Pendatkill/myradarhr05/README.md

<p align="center">
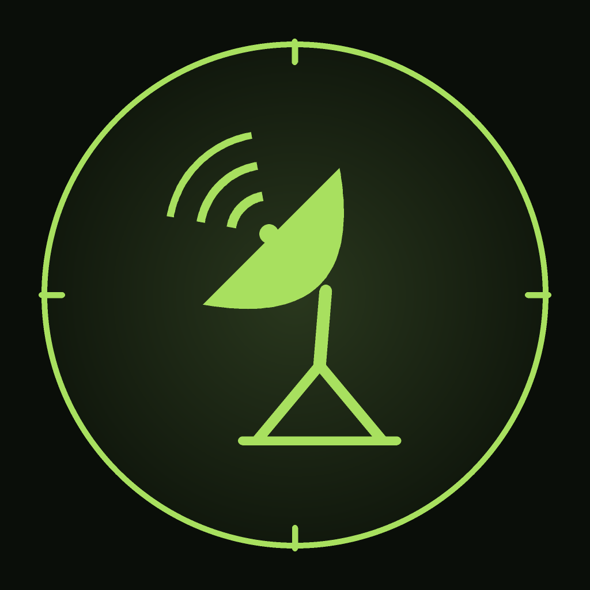
[picture p1: docs/icono_app.png]
Icono de My Radar: antena parabólica
  
</p>

<h1 align="center">My Radar</h1>
<p align="center">Radar ultrasónico con ESP32, visor web, visor de escritorio y app Android<br>by <b>pendatkill_dev</b></p>

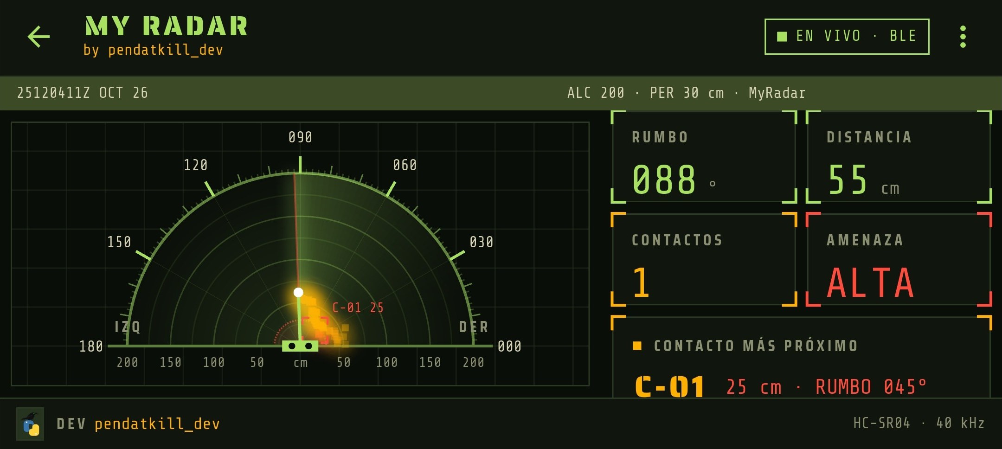
[picture p2: docs/app_radar.jpg]
App My Radar en un móvil Android, conectada por Bluetooth LE: radar semicircular con un contacto C-01 a 25 cm, rumbo 088°, distancia 55 cm y nivel de amenaza ALTA


Un sensor HC-SR04 montado sobre un servo SG90 barre 176° y mide la distancia a lo que tiene delante. El ESP32 envía cada medida por **USB**, **WiFi** y **Bluetooth LE**, y tres clientes la dibujan como una pantalla de radar:

| Cliente | Conexión | Carpeta |
|---|---|---|
| App Android **My Radar** (Flutter, estilo consola táctica) | WiFi o Bluetooth LE | [`my_radar_app/`](my_radar_app/) |
| Visor web (Chrome o Edge, sin instalar nada) | USB con Web Serial | [`visor_web/`](visor_web/) |
| Visor de escritorio (Python + pygame) | USB | [`visor_pc/`](visor_pc/) |

## El montaje

<p align="center">
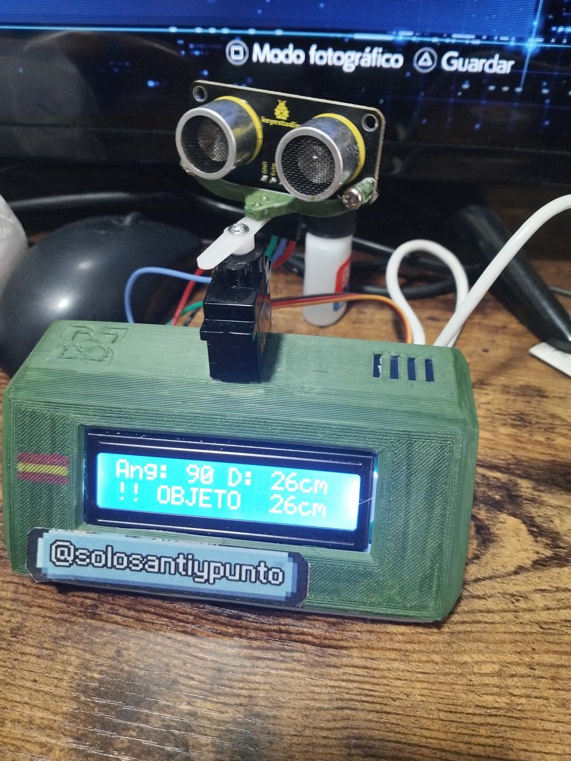
[picture p3: docs/montaje.jpg]
Radar montado: caja verde impresa en 3D con la pantalla LCD mostrando «Ang: 90 D: 26cm» y «!! OBJETO 26cm», el servo encima y el sensor ultrasónico sobre su brazo
  
</p>

Caja impresa en 3D con la pantalla LCD en el frente. El servo asoma por arriba y lleva el sensor en un soporte atornillado a su brazo. En la foto, la LCD avisa de un objeto a 26 cm, dentro del perímetro de alerta de 30 cm.

## Lista de materiales

| Cant. | Componente | Notas |
|---|---|---|
| 1 | Placa de desarrollo ESP32 (ESP32-WROOM-32) con USB-serie CH340 o CP2102 | Hace falta WiFi y Bluetooth LE |
| 1 | Sensor ultrasónico HC-SR04 | El firmware usa de 2 a 200 cm |
| 1 | Microservo SG90 | Con su brazo de plástico |
| 1 | Pantalla LCD 1602 con adaptador I2C (PCF8574) | Dirección 0x27; algunas usan 0x3F |
| 1 | Resistencia de 1 kΩ | Divisor de tensión del ECHO |
| 1 | Resistencia de 2 kΩ | Divisor de tensión del ECHO |
| 1 | Condensador electrolítico de 470–1000 µF, 10 V o más | En la alimentación del servo |
| 1 | Fuente de 5 V y 1 A | Recomendada para el servo |
| ~10 | Cables dupont | Según tu montaje, macho-hembra o hembra-hembra |
| 1 | Cable USB de datos | Uno solo de carga no sirve para programar |
| 1 | Caja y soporte del sensor impresos en 3D | PLA. Ver [Piezas impresas en 3D](#piezas-impresas-en-3d) |
| — | Tornillería pequeña | Para fijar el soporte al brazo del servo |

## Piezas impresas en 3D

Hay muchos diseños libres para este montaje. Busca uno que encaje con tus componentes:

| Pieza | Yeggi | Cults3D |
|---|---|---|
| Radar completo (sensor + servo) | [Buscar](https://www.yeggi.com/q/ultrasonic+radar+servo/) | [Buscar](https://cults3d.com/en/search?q=ultrasonic+radar) |
| Soporte del HC-SR04 para el brazo del SG90 | [Buscar](https://www.yeggi.com/q/hc-sr04+sg90+mount/) | [Buscar](https://cults3d.com/en/search?q=hc-sr04+servo+mount) |
| Caja para LCD 1602 | [Buscar](https://www.yeggi.com/q/lcd+1602+case/) | [Buscar](https://cults3d.com/en/search?q=lcd+1602+case) |
| Caja para ESP32 | [Buscar](https://www.yeggi.com/q/esp32+case/) | [Buscar](https://cults3d.com/en/search?q=esp32+case) |

Antes de imprimir, comprueba las medidas de tu placa ESP32 y de tu LCD: varían entre fabricantes.

## Conexiones

| Componente | Pin del ESP32 |
|---|---|
| Servo SG90 (señal) | GPIO 18 |
| HC-SR04 TRIG | GPIO 19 |
| HC-SR04 ECHO | GPIO 23, **a través de un divisor de tensión** |
| LCD 1602 I2C | SDA GPIO 21 · SCL GPIO 22 |

> **ECHO a 5 V.** El HC-SR04 devuelve 5 V y los GPIO del ESP32 solo admiten 3,3 V. Pon un divisor `ECHO — 1 kΩ — GPIO23 — 2 kΩ — GND` o usa un HC-SR04P alimentado a 3,3 V.
>
> **Servo.** Aliméntalo con una fuente de 5 V aparte (GND común) y un condensador de 470–1000 µF. Sus picos de consumo pueden reiniciar el ESP32.

## Puesta en marcha

### 1. Firmware

Abre [`firmware/radar_esp32/radar_esp32.ino`](firmware/radar_esp32/radar_esp32.ino) en el IDE de Arduino.

- Placa: **ESP32 Dev Module** (core ESP32 2.x).
- Esquema de particiones: **Huge APP (3MB No OTA)**. Con WiFi y Bluetooth el programa ocupa 1,3 MB y no cabe en el esquema por defecto.
- Librerías: **ESP32Servo** (1.x con el core 2.x, 3.x con el core 3.x) y **LiquidCrystal I2C** de Frank de Brabander.

Con `arduino-cli`:

```sh
arduino-cli compile --fqbn esp32:esp32:esp32:PartitionScheme=huge_app firmware/radar_esp32
arduino-cli upload  --fqbn esp32:esp32:esp32:PartitionScheme=huge_app -p COM5 firmware/radar_esp32
```

Al arrancar, la LCD muestra durante unos segundos cómo conectarse.

### 2. App Android

Descarga [`apk/MyRadar_v1.0.0_arm64.apk`](apk/MyRadar_v1.0.0_arm64.apk) (17 MB) en el móvil y ábrelo. Android pedirá permiso para «instalar apps de origen desconocido».

Este APK funciona en móviles de 64 bits (arm64), que son casi todos los fabricados desde 2017. Para un móvil antiguo de 32 bits, o para modificar la app, compílala:

```sh
cd my_radar_app
flutter pub get
flutter build apk --release      # APK universal para cualquier móvil
```

La app ofrece tres canales:

- **Bluetooth LE:** escanea y enlaza con «MyRadar». No hace falta emparejar.
- **WiFi:** el radar crea siempre la red `MyRadar` (IP `192.168.4.1`). Desde el menú de la app puedes darle tu WiFi de casa; entonces se une a ella y la app lo encuentra sola.
- **Simulación:** datos de prueba, sin radar.

### 3. Visor web

Abre [`visor_web/index.html`](visor_web/index.html) en **Chrome o Edge**, pulsa **Conectar ESP32** y elige el puerto USB. Arranca en modo demo.

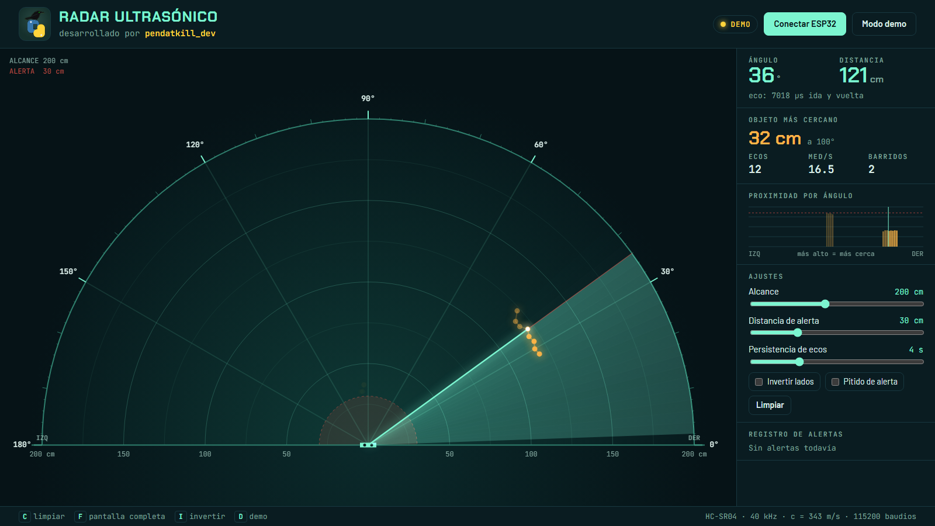
[picture p4: docs/visor_web.png]
Visor web del radar en modo demo, con panel de lectura, proximidad por ángulo y ajustes


### 4. Visor de escritorio

```sh
pip install pygame pyserial
python visor_pc/radar_pc.py            # detecta el puerto solo
python visor_pc/radar_pc.py --demo     # sin hardware
```

Cierra el Monitor Serie de Arduino antes de abrir cualquier visor: solo un programa puede usar el puerto a la vez.

## Versiones probadas

| Herramienta o librería | Versión |
|---|---|
| Core ESP32 para Arduino | 2.0.x |
| ESP32Servo | 1.2.1 |
| LiquidCrystal I2C (Frank de Brabander) | 1.1.2 |
| Flutter / Dart | 3.44.1 / 3.12.1 |
| Android | 7.0 (API 24) o superior. Hasta Android 11, el Bluetooth LE pide permiso de ubicación |
| Python (visor de escritorio) | 3.11–3.13 con pygame 2.6 y pyserial 3.5 |

Con el core ESP32 3.x hace falta ESP32Servo 3.x. El resto del firmware no cambia, pero esa combinación no está probada.

## Problemas habituales

| Síntoma | Causa y solución |
|---|---|
| La compilación dice que el sketch es demasiado grande | Elige el esquema de particiones **Huge APP** |
| La distancia siempre es `-1` | TRIG y ECHO intercambiados, o falta alimentación del sensor. Prueba a cambiar los pines 19 y 23 |
| La LCD se enciende pero no muestra texto | Su dirección I2C es 0x3F: cámbiala en `LCD_DIR`. Si no, ajusta el contraste con el potenciómetro del adaptador |
| El ESP32 se reinicia al mover el servo | Caídas de tensión. Alimenta el servo aparte y añade el condensador |
| El visor web conecta pero no llegan datos | Pulsa el botón RST/EN de la placa. En Windows algunos adaptadores dejan el ESP32 en reset al abrir el puerto |
| «Acceso denegado» al abrir el puerto | Otro programa lo tiene abierto: cierra el Monitor Serie de Arduino o el otro visor |
| La app no conecta por la red MyRadar | Acepta «mantener la conexión» cuando Android avise de que esa WiFi no tiene internet |
| La app no encuentra el radar por Bluetooth | Comprueba que el Bluetooth y los permisos de «Dispositivos cercanos» están activos |
| Gradle falla con `PKIX path building failed` | Un antivirus o proxy inspecciona HTTPS. Añade su certificado raíz al almacén de Java o desactiva la inspección mientras compilas |

## Protocolo

El ESP32 envía una línea de texto por medida, unas 15 por segundo:

```
angulo,distancia_cm
```

`angulo` va de 2 a 178 (180 = izquierda). `distancia_cm` vale `-1` si no hay eco o si está fuera de 2–200 cm.

| Canal | Detalles |
|---|---|
| USB | 115200 baudios |
| WiFi | TCP, puerto 3333. En la WiFi de casa, anuncio UDP `MYRADAR <ip>` cada 2 s en el puerto 3334 |
| Bluetooth LE | Servicio UART de Nordic `6e400001-b5a3-f393-e0a9-e50e24dcca9e`. Medidas por notificación en TX (`…0003`), órdenes por escritura en RX (`…0002`) |

Órdenes que acepta por cualquier canal, terminadas en salto de línea:

| Orden | Efecto |
|---|---|
| `WIFI\|<red>\|<clave>` | Guarda la WiFi de casa y reinicia |
| `WIFIOFF` | Olvida la WiFi de casa y reinicia |
| `INFO` | Responde `INFO ap=<ip> sta=<ip o ->` |

## Seguridad

La red propia `MyRadar` usa la clave por defecto `pendatkill`, que está publicada en este repositorio. Cámbiala en `CLAVE_AP` (firmware) y en `claveRedPropia` (`my_radar_app/lib/enlace.dart`) si vas a usar el radar fuera de casa. Las órdenes no requieren autenticación: cualquiera conectado a esa red o por Bluetooth puede cambiar la WiFi del radar.

## Estructura

```
apk/                    App Android lista para instalar
firmware/radar_esp32/   Firmware del ESP32 (Arduino)
my_radar_app/           App Android en Flutter
visor_web/              Visor web con Web Serial
visor_pc/               Visor de escritorio en Python
docs/                   Imágenes del README
```

## Licencias

El código es de **pendatkill_dev** y se publica bajo licencia [MIT](LICENSE).

- **Tipografías de la app:** Saira Stencil One, Saira Condensed y Share Tech Mono, bajo la SIL Open Font License. Sus textos de licencia están en [`my_radar_app/assets/fonts/`](my_radar_app/assets/fonts/).
- **flutter_blue_plus:** la app usa esta librería para el Bluetooth. Es gratuita para uso personal, educativo y sin ánimo de lucro; el uso comercial necesita su licencia de pago.
