Pendatkill/myradarhr05/my_radar_app/assets/antena.png

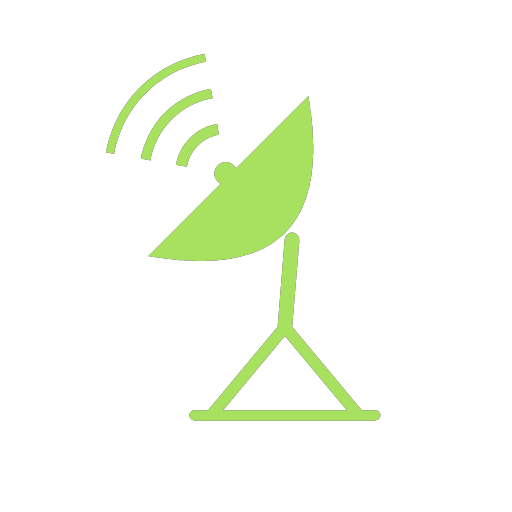
my_radar_app/assets/antena.png
