Pendatkill/myradarhr05/(commit log)

2026-10-25 My Radar: radar ultrasónico ESP32 con app Android, visor web y visor PC
    - Firmware ESP32: barrido con servo, HC-SR04, LCD I2C y envío de medidas
    por USB, WiFi (TCP 3333, red propia + WiFi de casa con anuncio UDP) y
    Bluetooth LE (UART de Nordic). Órdenes WIFI, WIFIOFF e INFO.
    - App Android en Flutter con estilo de consola táctica: canales BLE, WiFi
    y simulación, contactos, nivel de amenaza y bitácora de alertas.
    - Visor web con Web Serial para Chrome/Edge y visor de escritorio en pygame.
2026-10-25 Añade foto del montaje y lista de materiales
2026-10-25 Añade enlaces a Yeggi y Cults3D para las piezas impresas en 3D
2026-10-25 Añade captura de la app Android al README
2026-10-25 Corrige el rumbo de los contactos en la app
    El rumbo se calculaba como la media de todos los ecos del grupo y no
    coincidía con la posición dibujada. Ahora usa el eco más cercano.
2026-10-25 Añade el APK de la app en apk/
